s190858/xdac-v3/(list of files, drawings)

Other design files:
ADC-DAC.SchDoc
ChipSelects+Faults.SchDoc
Fan & Power Out.SchDoc
iDAC1.SchDoc
iDAC2.SchDoc
LIM+LEDS+POWER.SchDoc
PD.SchDoc
PI_INTERFACE.SchDoc
PIC closed loop.SchDoc
Pilot.PcbLib
Pilot.SchLib
PIO.SchDoc
Power.SchDoc
RX_FlexiConnectors.SchDoc
TEC_CONTROLLER_1.SchDoc
TEC_CONTROLLER_2.SchDoc
TEC_CONTROLLER_3.SchDoc
TX_FlexiConnectors.SchDoc
vDAC1.SchDoc
vDAC2.SchDoc
xDAC-v3.PrjPcb
xDAC_Carrier1/test.pcblib
xDAC_Carrier1/xDAC_Carrier.SCHLIB
